AEFeinstein/Swadge-S2-Devkit/Swadge-S2-Devkit/Swadge-S2-Devkit.kicad_pcb

## KiCad design Swadge-S2-Devkit/Swadge-S2-Devkit.kicad_pcb (2022-06-26)

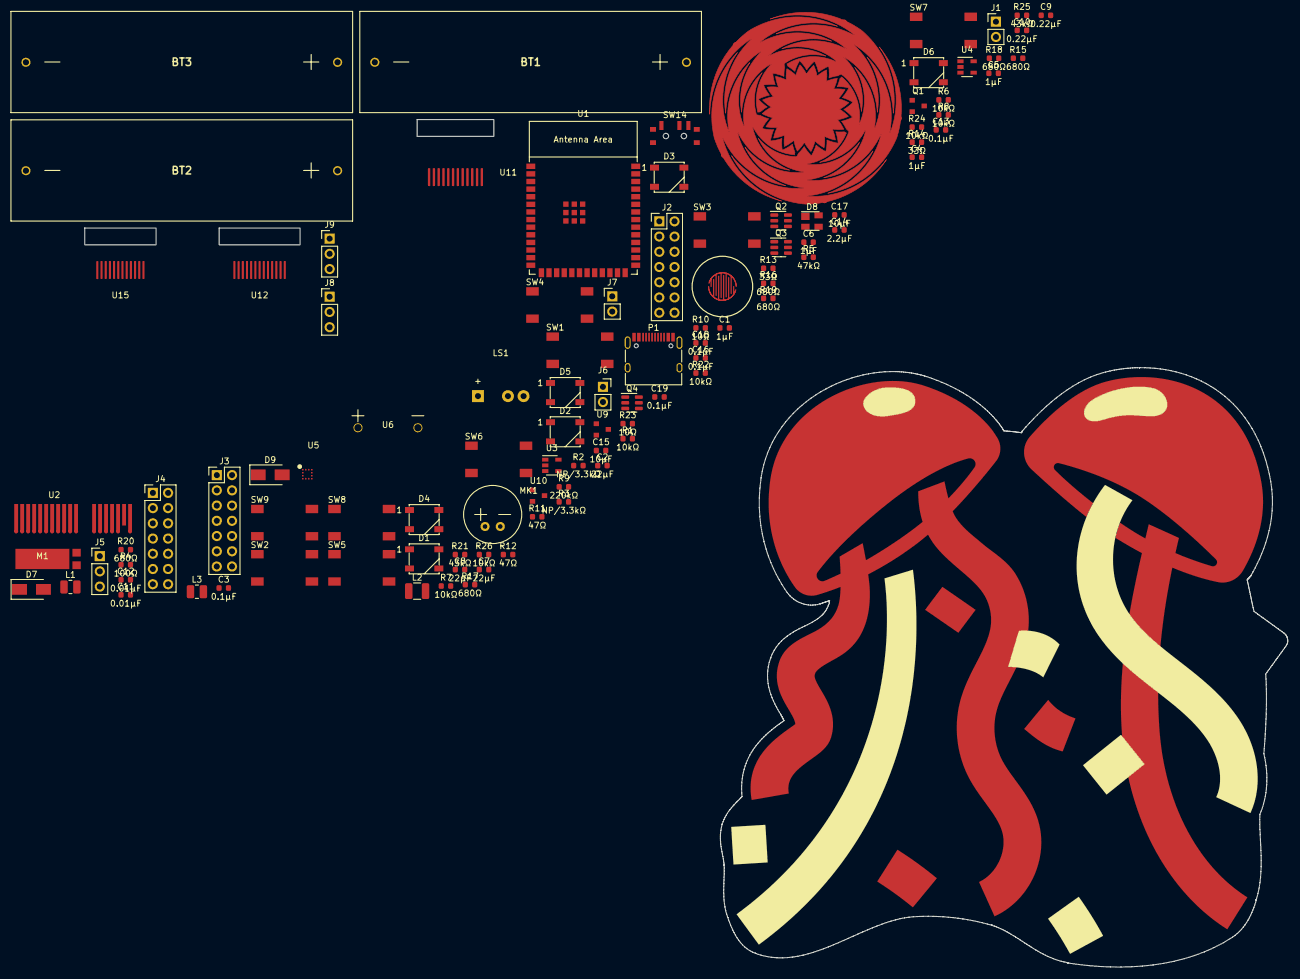
[picture p1: board Swadge-S2-Devkit.kicad_pcb from above]

Board: 2 copper layers, 200.7 x 141.4 mm, 100 parts (0 on the bottom side), 83 nets, no tracks yet.

Parts:
BT1, BT2, BT3: Battery; 2460
C1, C4, C5, C6: 1μF; C_0603_1608Metric
C2, C7, C8: 22μF; C_0603_1608Metric
C3, C13, C16, C18, C19: 0.1μF; C_0603_1608Metric
C9, C10: 0.22μF; C_0603_1608Metric
C11, C12: 0.01μF; C_0603_1608Metric
C14: 2.2μF; C_0603_1608Metric
C15, C17: 10μF; C_0603_1608Metric
D1, D2, D3, D4, D5, D6: WS2812B; LED_WS2812B_PLCC4_5.0x5.0mm_P3.2mm
D7, D9: D; D_SMA
D8: SP0503BAHT; SOT-143
J1: CurrentMonitor; PinHeader_1x02_P2.54mm_Vertical
J2: DEBUG_BANK_C; PinHeader_2x07_P2.54mm_Vertical
J3: DEBUG_BANK_B; PinHeader_2x07_P2.54mm_Vertical
J4: DEBUG_BANK_A; PinHeader_2x07_P2.54mm_Vertical
J5: MICSEL; PinHeader_1x03_P2.54mm_Vertical
J6: TRYMIC; PinSocket_1x02_P2.54mm_Vertical
J7: LEDK_J; PinHeader_1x02_P2.54mm_Vertical
J8: LCD18; PinHeader_1x03_P2.54mm_Vertical
J9: LCD28; PinHeader_1x03_P2.54mm_Vertical
L1, L3: 2.2uH; L_1008_2520Metric
L2: 100uH; L_1210_3225Metric
LS1: Buzzer; Buzzer_12x9.5RM7.6
M1: VZ43FC1B5640007L
MK1: Microphone; CMA-4544PF-W
P1: USB_C_Plug_USB2.0; USB_C_Receptacle_HRO_TYPE-C-31-M-12
Q1: Q_N_FET; SOT-23
Q2, Q3, Q4: AP2003_PN_FET; SOT-23-6
R1, R6, R7, R8, R22, R24, R26: 10kΩ; R_0603_1608Metric
R2, R3: NP/3.3kΩ; R_0603_1608Metric
R4: 100Ω; R_0603_1608Metric
R5: 47kΩ; R_0603_1608Metric
R9: 220kΩ; R_0603_1608Metric
R10, R23: 10Ω; R_0603_1608Metric
R11, R12: 47Ω; R_0603_1608Metric
R13, R14: 33Ω; R_0603_1608Metric
R15, R16, R17, R18, R19, R20: 680Ω; R_0603_1608Metric
R21, R25: 43kΩ; R_0603_1608Metric
SW1, SW2, SW3, SW4, SW5, SW6, SW7, SW8, SW9: 4-1437565-2; SW_4-1437565-2
SW10: BLISTER_SILICONE_BUTTON; BTC007_Button_Silicone
SW11: touch-ring-6; Touch_Teeth_5
SW14: SW_SPDT; SW_SPDT_PCM12
U1: ESP32-S2-SOLO
U2: BUS_PCIexpress
U3: MT3410; SOT-23-5
U4: GS321-TR; SOT-23-5
U5: QMA7981; QMA6981
U6: INGHAi_GSPK2308P-8R0.5W; INGHAi GSPK2308P-8R0.5W
U9: GENERIC_LDO_1.8; SOT-23
U10: GENERIC_LDO_2.8; SOT-23
U11: LCD_240x240_1.3_12
U12: LCD_135x240_1.14_13
U15: LCD_240x240_1.54_12

Connections:
5VIN: D8.4 (K), D9.2 (A), P1.A4_B9 (VBUS), P1.A9_B4 (VBUS)
+3V3: C2.1, C3.1, C4.1, C5.1, C6.1, C12.1, C13.1, C14.1, C15.2, C16.1, C17.1, D1.1 (VDD), D2.1 (VDD), D3.1 (VDD), D4.1 (VDD), D5.1 (VDD), D6.1 (VDD), D7.1 (K), J4.2, J8.1, J9.1, L1.1, L3.1, M1.2 (+), Q4.2 (S2), R1.1, R2.2, R3.1, R10.2, R25.2, U1.2 (3V3), U2.A8, U2.B8, U5.3 (VDDIO), U5.7 (VDD), U5.10 (SENB), U9.3 (IN), U10.3 (IN), U12.10 (VDD), U15.4 (VDD)
+5V: D9.1 (K), J1.2, U2.A18, U2.B18
BATTMID: BT1.1 (+), BT2.2 (-)
BATTMID2: BT2.1 (+), BT3.2 (-)
BATTPLUS: BT3.1 (+), SW14.3 (C)
BLISTER1: J4.7, SW10.2, U1.7 (GPIO7/TOUCH7/ADC1_CH6)
BTN_1: J4.4, SW1.1, SW1.2, U1.4 (GPIO4/TOUCH4/ADC1_CH3)
BTN_2: J4.5, SW2.1, SW2.2, U1.5 (GPIO5/TOUCH5/ADC1_CH4)
BTN_3: J3.14, SW3.1, SW3.2, U1.26 (GPIO45), U2.A4, U2.B4
BTN_4: J3.4, SW4.1, SW4.2, U1.16 (GPIO46), U2.A3, U2.B3
BTN_5: J4.8, SW5.1, SW5.2, U1.8 (GPIO15/U0RTS/ADC2_CH4/XTAL_32K_P)
BTN_6: J2.2, SW6.1, SW6.2, U1.39 (GPIO1/TOUCH1/ADC1_CH0)
BTN_7: J2.3, SW7.1, SW7.2, U1.38 (GPIO2/TOUCH2/ADC1_CH1)
BTN_8: J2.14, SW8.1, SW8.2, U1.27 (GPIO0), U2.A2, U2.B2
BTN_9: J3.3, SW9.1, SW9.2, U1.15 (GPIO3/TOUCH3/ADC1_CH2)
BZR: J2.8, R23.1, U1.33 (MTDO/GPIO40/CLK_OUT2)
DIPRAIL: L1.2, Q2.2 (S2), Q3.2 (S2)
EN: C1.1, J4.3, R1.2, U1.3 (EN)
GND: BT1.2 (-), C1.2, C2.2, C3.2, C4.2, C5.2, C6.2, C7.2, C8.1, C9.1, C12.2, C13.2, C14.2, C15.1, C16.2, C17.2, C18.2, C19.2, D1.3 (VSS), D2.3 (VSS), D3.3 (VSS), D4.3 (VSS), D5.3 (VSS), D6.3 (VSS), D8.1 (A), J2.1, J3.1, J3.2, J4.1, J6.1, J7.1, LS1.2, M1.1 (GND), MK1.1 (-), P1.A1_B12 (GND), P1.A12_B1 (GND), P1.S1 (SHIELD), Q1.2 (S), Q2.5 (S1), Q3.5 (S1), Q4.5 (S1), R6.1, R22.2, R24.1, R26.2, SW1.3, SW1.4, SW2.3, SW2.4, SW3.3, SW3.4, SW4.3, SW4.4, SW5.3, SW5.4, SW6.3, SW6.4, SW7.3, SW7.4, SW8.3, SW8.4, SW9.3, SW9.4, SW10.1, SW14.4 (D), SW14.5 (E), SW14.6 (F), SW14.7 (G), U1.1 (GND), U1.40 (GND), U1.41 (GND), U2.A1, U2.B1, U3.2 (GND), U4.2 (VSS), U5.1 (AD0), U5.4 (RESV1), U5.8 (GNDIO), U5.9 (GND), U9.1 (GND), U10.1 (GND), U11.3 (GND), U11.10 (GND), U11.12 (GND), U12.8 (GND), U12.13 (GND), U15.1 (GND), U15.5 (GND), U15.6 (GND), U15.12 (GND)
LCD18: C18.1, J8.2, U11.5 (VDD18)
LCD28: C19.1, J9.2, U11.4 (VDD28)
LED: J2.9, R4.2, U1.32 (MTCK/GPIO39/CLK_OUT3), U2.A17, U2.B17
LED_OUT: D6.2 (DOUT), U2.A11, U2.B11
MIC: J4.12, J5.2, U1.12 (GPIO8/TOUCH8/ADC1_CH7)
MOTOR: J4.9, Q1.1 (G), U1.9 (GPIO16/U0CTS/ADC2_CH5/XTAL_32K_N)
unnamed: C7.1, R21.2, SW14.2 (B), U3.1 (EN), U3.4 (VIN)
unnamed: C8.2, C9.2, R5.2, R7.1, R10.1, U4.5 (VDD)
unnamed: C10.1, R8.2
unnamed: C10.2, J5.1, J6.2, MK1.2 (+), R7.2
unnamed: C11.1, J5.3, R9.1, U4.4 (OUT)
unnamed: C11.2, R8.1, R9.2, U4.3 (IN-)
unnamed: D1.2 (DOUT), D2.4 (DIN)
unnamed: D1.4 (DIN), R4.1
unnamed: D2.2 (DOUT), D3.4 (DIN)
unnamed: D3.2 (DOUT), D4.4 (DIN)
unnamed: D4.2 (DOUT), D5.4 (DIN)
unnamed: D5.2 (DOUT), D6.4 (DIN)
unnamed: D7.2 (A), M1.3 (-), Q1.3 (D)
unnamed: D8.2 (K), P1.A6 (DP1), R13.2
unnamed: D8.3 (K), P1.A7 (DN1), R14.2
unnamed: J1.1, SW14.1 (A)
unnamed: J8.3, U9.2 (OUT)
unnamed: J9.3, U10.2 (OUT)
unnamed: L2.1, Q4.4 (D2)
unnamed: L3.2, U3.3 (LX)
unnamed: LS1.1, R23.2
unnamed: Q2.4 (D2), Q2.6 (D1), U6.2 (-)
unnamed: Q3.4 (D2), Q3.6 (D1), U6.1 (+)
unnamed: R5.1, R6.2, U4.1 (IN+)
unnamed: R11.2, U5.2 (SDX)
unnamed: R12.2, U5.12 (SCX)
unnamed: R15.1, SW11.1 (0)
unnamed: R16.1, SW11.2 (60)
unnamed: R17.1, SW11.3 (120)
unnamed: R18.1, SW11.4 (180)
unnamed: R19.1, SW11.5 (240)
unnamed: R20.1, SW11.6 (300)
unnamed: R24.2, R25.1, U3.5 (FB)
RX: J2.5, U1.36 (U0RXD/GPIO44/CLK_OUT2), U2.A16, U2.B16
SCL: J4.11, R2.1, R12.1, U1.11 (GPIO18/U1RXD/ADC2_CH7/DAC_2/CLK_OUT3)
SDA: J4.10, R3.2, R11.1, U1.10 (GPIO17/U1TXD/ADC2_CH6/DAC_1)
SP+: J2.6, Q3.1 (G1), Q3.3 (G2), U1.35 (MTMS/GPIO42)
SP-: J2.7, Q2.1 (G1), Q2.3 (G2), U1.34 (MTDI/GPIO41/CLK_OUT1)
TFTATN: J3.12, Q4.1 (G1), U1.24 (SPIIO4/GPIO33/FSPIHD)
TFTATP: J2.13, Q4.3 (G2), U1.28 (SPIIO6/GPIO35/FSPID)
TFT_CS: J3.13, U1.25 (SPIIO5/GPIO34/FSPICS0), U11.6 (LCMCS), U12.7 (CS), U15.8 (CS)
TFT_LEDA: L2.2, Q4.6 (D1), U11.2 (LEDA), U12.12 (LEDA), U15.3 (LEDA)
TFT_LEDK: J7.2, U11.1 (LEDK), U12.11 (LEDK), U15.2 (LEDK)
TFT_RESET: J2.10, U1.31 (GPIO38/FSPIWP), U11.7 (LCM-RST), U12.6 (RESET), U15.11 (RESET)
TFT_RS: J3.11, R26.1, U1.23 (GPIO21), U11.11 (LCM-CD), U12.5 (RS), U15.7 (A0)
TFT_SCL: J2.12, U1.29 (SPIIO7/GPIO36/FSPICLK), U11.8 (LCM-SCL), U12.4 (SCL), U15.9 (SCLK)
TFT_SDA: J2.11, U1.30 (SPIDQS/GPIO37/FSPIQ), U11.9 (LCM-SDA), U12.3 (SDA), U15.10 (SDA)
TOUCH_1: R15.2, U1.17 (GPIO9/TOUCH9/ADC1_CH8/FSPIHD)
TOUCH_2: R16.2, U1.18 (GPIO10/TOUCH10/ADC1_CH9/FSPICS0/FSPIIO4)
TOUCH_3: R17.2, U1.19 (GPIO11/TOUCH11/ADC2_CH0/FSPID/FSPIIO5)
TOUCH_4: R18.2, U1.20 (GPIO12/TOUCH12/ADC2_CH1/FSPICLK/FSPIIO6)
TOUCH_5: R19.2, U1.21 (GPIO13/TOUCH13/ADC2_CH2/FSPIQ/FSPIIO7)
TOUCH_6: R20.2, U1.22 (GPIO14/TOUCH14/ADC2_CH3/FSPIWP/FSPIDQS)
TX: J2.4, U1.37 (U0TXD/GPIO43/CLK_OUT1), U2.A15, U2.B15
USB_D+: J4.14, R13.1, U1.14 (GPIO20/U1CTS/ADC2_CH9/CLK_OUT1/USB_D+)
USB_D-: J4.13, R14.1, U1.13 (GPIO19/U1RTS/ADC2_CH8/CLK_OUT2/USB_D-)
VMON: J4.6, R21.1, R22.1, U1.6 (GPIO6/TOUCH6/ADC1_CH5)
