AEFeinstein/Swadge-S2-Devkit/(threads)

Thread 1 (2022-01-14):

Validate Schematic

AEFeinstein, 2022-01-14:
Blocks to validate:
- [x] ESP32-S2
- [x] Buttons
- [x] Microphone
- [x] Speaker
- [x] Buzzer
- [x] TFT Display
- [x] LEDs
- [x] Vibration Motor
- [x] Edge Connector
- [x] Pin Headers
- [x] Accelerometer
- [x] USB
- [x] Touch Sensor

Closed 2022-09-02.

Thread 4 (2022-09-02):

Prototype Feedback

AEFeinstein, 2022-09-02:
# Silkscreen
 - [x] Replace chevron silkscreen with X/Y silkscreen
 - [x] Add silkscreen for power switch sides
 - [x] Add URL silkscreen "swadge.com/super2023/"
 - [x] Add e-mail silkscreen circuitboards@magfest.org
 - [x] Add version silkscreen (1.0.1)
 - [x] Add A and B button silkscreen
 - [x] Add silkscreen dot or marking or something for UP on the D-Pad to indicate "programming mode button"
 - [x] "Yes these are buttons"

# LEDs
 - [ ] Fix LED placement
 - [ ] Swap LED types

# Kidneys
 - [x] Enlarge holes for kidney mounting. reimport footprint for both main part and PCB
 - [x] Tie all kidney mounting holes to GND, not VCC.
 - [ ] Decide shield location
 - [ ] Either use a thicker kidney (1.6mm) or add another mounting point at the bottom of the controller grip
 - [ ] Pick a kidney!

# Part Placement
 - [x] Move SAO out from under kidney, flip to front of Swadge
 - [x] Rotate start/select 90 degrees, push closer together, move TFT upwards
 - [x] Update TFT part to accommodate either long or short tail, just in case (@cnlohr to email Ronbo)
 - [x] Move power switch up to not hang over the board so much (flush)

# Misc
 - [x] Remove UART pads (nah, let's leave them)
 - [x] Pick a microphone, scrap the other, move it to original location (@cnlohr, you get to pick. My preference is for the larger one to balance the buzzer)
 - [x] Mic pullup needs to be 10k
 - [x] R3 needs to be 10k
 - [x] Remove or shrink button debounce caps
 - [x] Add CC1/CC2 pullups for USB-C power

# BOM
 - [x] Use low-force buttons for A/B (https://lcsc.com/product-detail/Tactile-Switches_XKB-Connectivity-TS-1103S-B-A_C2929546.html is the best I could find)
 - [x] DNP the SAO.
 - [x] R5 has wrong LCSC part #

AEFeinstein, 2022-09-02:
@cnlohr, as far as division of labor, I would prefer if you update the mic components & BOM stuff. I can do the silkscreen and part placement (and probably the rerouting too)

cnlohr, 2022-09-03:
[ ] SAO movement.
[ ] Make Switch flush with board.

cnlohr, 2022-09-03:
- [ ] Move microphone to where old mic was.

cnlohr, 2022-09-03:
- [ ] Try to make the switch go right up next to the USB.

AEFeinstein, 2022-09-04:
> SAO movement.
"Move SAO out from under kidney, flip to front of Swadge" in the ticket description

> Make Switch flush with board.
"Move power switch up to not hang over the board so much (flush)" in the ticket description

> Move microphone to where old mic was.
"Pick a microphone, scrap the other, move it to original location" in the ticket description

> Try to make the switch go right up next to the USB.
Was this feedback from the jam?

cnlohr, 2022-09-05:
Only thing I think I need to answer is that yes, switch up was feedback from jam.  @AEFeinstein are you OK with that?  Looks like you already fixed it. You did fix it right?  I'm not crazy?

Closed 2022-09-06.

Thread 6 (2022-09-06):

Fix SW9 silkscreen + Move ring

cnlohr, 2022-09-06:
Says in title.

This is post EV2

AEFeinstein, 2022-09-06:
What's wrong with SW9? BT1 needs to be reset to have (-) be aligned

cnlohr, 2022-09-06:
Aaah ok

Plx assign to me.  I have the semaphore.  I am currently balancing both branches. I'd rather not make mods until the orders are in.

AEFeinstein, 2022-09-06:
Reassigned. Have fun balancing the branches. Kicad files aren't that git friendly 😟

As a general note, when you're done with branches (either merged or abandoned), remember to delete them!

cnlohr, 2022-09-21:
SW9 was resolved at some point..
Ring looks "too low" based on screen silk.

<div style="font-family:Verdana,Geneva,sans-serif"><span class="im">
<p>Dear Charles,</p>
<p>Thanks for your feedback!</p>
</span><p>I understand the situation of your production prototypes, sorry for your confuse!</p>
<p>I will provide the old ones (yellow) which are measured to be 32mm,</p>
<p>please design your production prototypes according to this 32mm length,</p><span class="im">
<p>Have a nice day!</p></span></div></div></div></div>

AEFeinstein, 2022-09-21:
> SW9 was resolved at some point.

OK, I'm not going crazy

> Ring looks "too low" based on screen silk.

I fixed that in the `more-cad` branch when doing Dac's render. PR here: https://github.com/AEFeinstein/Swadge-S2-Devkit/pull/7

Closed 2022-10-30.

Thread 8 (2023-08-09):

Need replacement LCD

camprevail, 2023-08-09:
Hi, I cracked my 2023 swadge LCD and I searched through this repo but I can't find the LCD model used so I can replace it. Can you help me out?

AEFeinstein, 2023-08-09:
The info is buried in the BOM in the release zip, but it's a RB017A1505A from http://www.ronboe.com/ or https://ronboelectronics.en.made-in-china.com/ (I'm not sure why they have two websites). The part isn't listed, but if you email you may be able to get a sample. We bought a large quantity and I'm not sure how they feel about single orders.

Closed 2023-08-09.
