AEFeinstein/Swadge-S2-Devkit/(commit log)

2022-03-26 Switched to controller PCB
    [Swadge-S2-Devkit.kicad_pcb, Swadge-S2-Devkit.kicad_sch]
2022-04-05 Ripped all traces, adjusted part placement
    [Swadge-S2-Devkit.kicad_pcb]
2022-04-05 Added annotated schematic
    [Swadge-S2-Devkit.kicad_sch]
2022-06-26 Messing around with another party ball
    [Swadge-S2-Devkit.kicad_pcb]
